Hypernova-Oy/emb-toveri/KiCad/authenticator/old.kicad_pcb

## KiCad design KiCad/authenticator/old.kicad_pcb (2019-07-12, an earlier design)

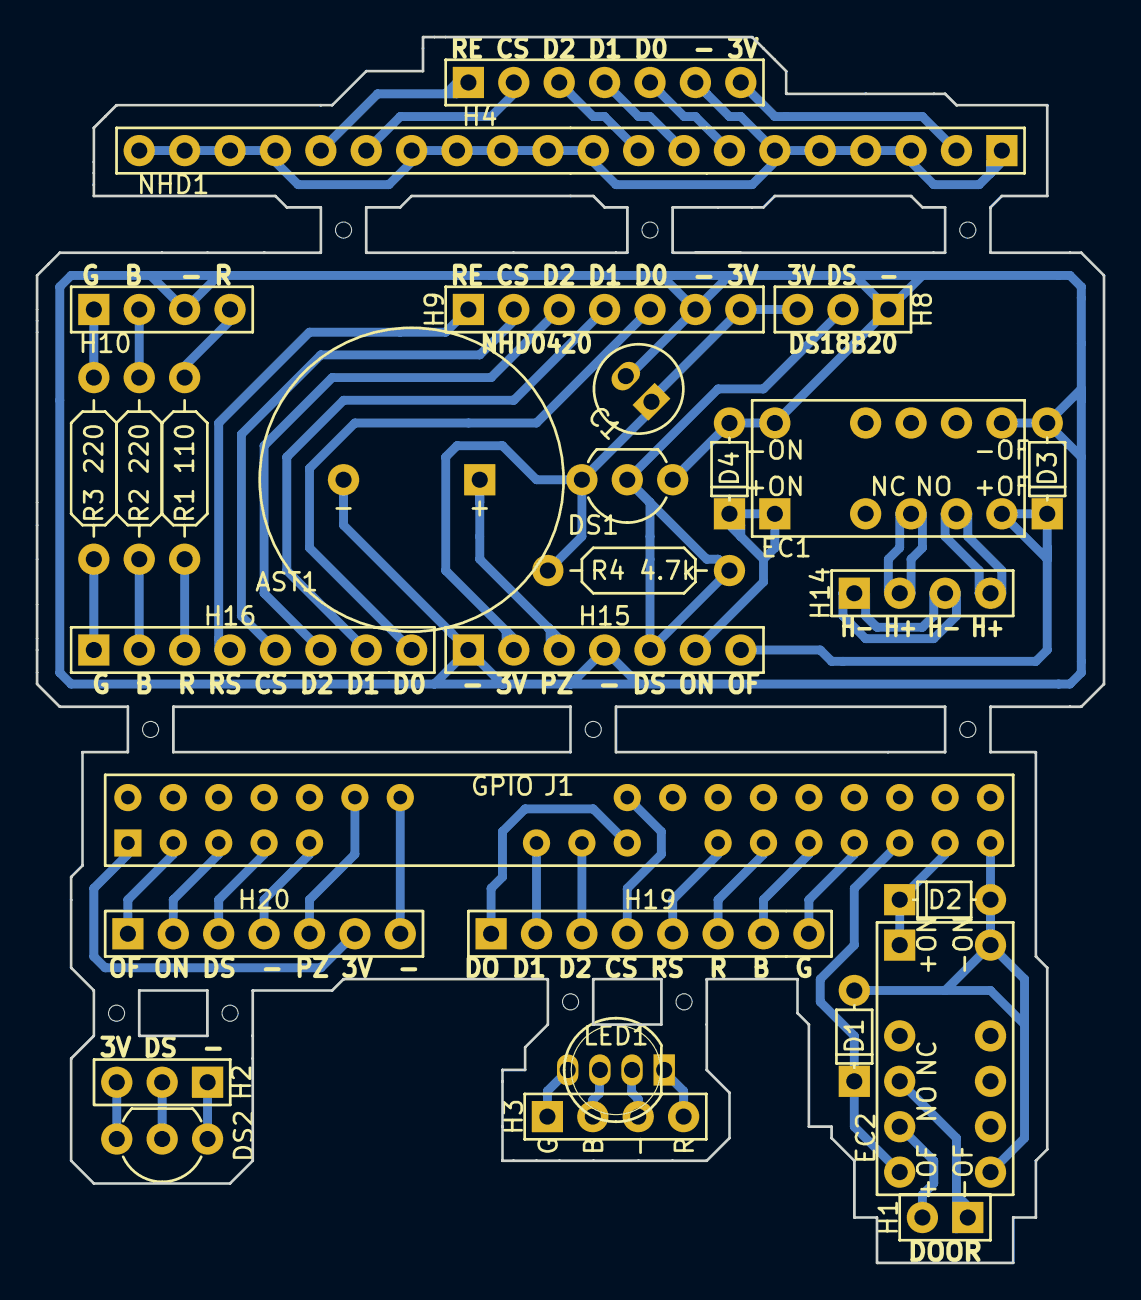
[picture p3: board old.kicad_pcb from above]

Board: 2 copper layers, 59.7 x 68.6 mm, 29 parts (0 on the bottom side), 54 nets.

Parts:
AST1: AST-1732MR-R
C1: CP; UMW0G101MDD
D1, D2, D3, D4: D; 1N4154TAP
DS1, DS2: DS18B20+; TO-92_Inline_Wide
EC1, EC2: EC2-3TNU
H1: HEADER_A_1X02; Pin_Header_Straight_1x02_Pitch2.54mm
H2, H8: HEADER_S_1X03; Pin_Header_Straight_1x03_Pitch2.54mm
H3, H10: HEADER_S_1X04; Pin_Header_Straight_1x04_Pitch2.54mm
H4, H9: HEADER_S_1X07; Pin_Header_Straight_1x07_Pitch2.54mm
H14: HEADER_A_1X04; Pin_Header_Angled_1x04_Pitch2.54mm
H15, H20: HEADER_A_1X07; Pin_Header_Angled_1x07_Pitch2.54mm
H16, H19: HEADER_A_1X08; Pin_Header_Angled_1x08_Pitch2.54mm
J1: RPi_GPIO; PI_GPIO_Header_F_2x20
LED1: WP154A4SUREQBFZGC
NHD1: NHD-0420CW-AB3; Pin_Header_Straight_1x20_Pitch2.54mm
R1 110: 110; Resistor_ThroughHole_6.3x2.3mm_Spacing2.54mm
R2 220, R3 220: 220; Resistor_ThroughHole_6.3x2.3mm_Spacing2.54mm
R4 4.7k: 4.7k; Resistor_ThroughHole_6.3x2.3mm_Spacing2.54mm

Connections:
/3V3: C1.1, DS1.3, H8.3, H9.7, H15.2, R4 4.7k.2
/DS18B20: DS1.2, H8.2, H15.5, R4 4.7k.1
/GND: AST1.2, C1.2, D3.2, D4.2, DS1.1, EC1.7, EC1.12, H8.1, H9.6, H10.3, H15.1, H15.4
/HEAT_OFF: D3.1, EC1.6, H15.7
/HEAT_ON: D4.1, EC1.1, H15.6
/Heater+: EC1.4, H14.2
/Heater-: H14.1, H14.3
/HeaterPSU+: EC1.5, H14.4
/LED_B: H16.2, R2 220.1
/LED_G: H16.1, R3 220.1
/LED_R: H16.3, R1 110.1
/NHD0420CW_over_SPI/3V3: H4.7, NHD1.2
/NHD0420CW_over_SPI/CS: H4.2, NHD1.15
/NHD0420CW_over_SPI/D0: H4.5, NHD1.7
/NHD0420CW_over_SPI/D1: H4.4, NHD1.8
/NHD0420CW_over_SPI/D2: H4.3, NHD1.9
/NHD0420CW_over_SPI/GND: H4.6, NHD1.1, NHD1.3, NHD1.4, NHD1.5, NHD1.6, NHD1.10, NHD1.11, NHD1.12, NHD1.13, NHD1.14, NHD1.17, NHD1.18, NHD1.19, NHD1.20
/NHD0420CW_over_SPI/RES: H4.1, NHD1.16
/OLED_CS: H9.2, H16.5
/OLED_D0: H9.5, H16.8
/OLED_D1: H9.4, H16.7
/OLED_D2: H9.3, H16.6
/OLED_RES: H9.1, H16.4
/PIEZO: AST1.1, H15.3
/PiHat_3V3: H20.6, J1.1
/PiHat_35_doorOFF: D1.1, EC2.6, J1.35
/PiHat_37_doorON: D2.1, EC2.1, J1.37
/PiHat_39_doorGND: D1.2, D2.2, EC2.7, EC2.12, J1.39
/PiHat_CE0/CS: H19.4, J1.24
/PiHat_CLK/SCLK/D0: H19.1, J1.23
/PiHat_DS18B20: H20.3, J1.7
/PiHat_GND1: H20.7, J1.14
/PiHat_GND2: H20.4, J1.9
/PiHat_HEAT_OFF: H20.1, J1.3
/PiHat_HEAT_ON: H20.2, J1.5
/PiHat_LED_B: H19.7, J1.31
/PiHat_LED_G: H19.8, J1.33
/PiHat_LED_R: H19.6, J1.29
/PiHat_MISO/SDO/D2: H19.3, J1.21
/PiHat_MOSI/SDI/D1: H19.2, J1.19
/PiHat_PIEZO: H20.5, J1.12
/PiHat_RES: H19.5, J1.27
unnamed: DS2.1, H2.1
unnamed: DS2.2, H2.2
unnamed: DS2.3, H2.3
unnamed: EC2.4, H1.1
unnamed: EC2.5, H1.2
unnamed: H3.1, LED1.4
unnamed: H3.2, LED1.3
unnamed: H3.3, LED1.2
unnamed: H3.4, LED1.1
unnamed: H10.1, R3 220.2
unnamed: H10.2, R2 220.2
unnamed: H10.4, R1 110.2
